hlotze/2_plus_7-Segmentanzeige/images/IMG_0500.JPG

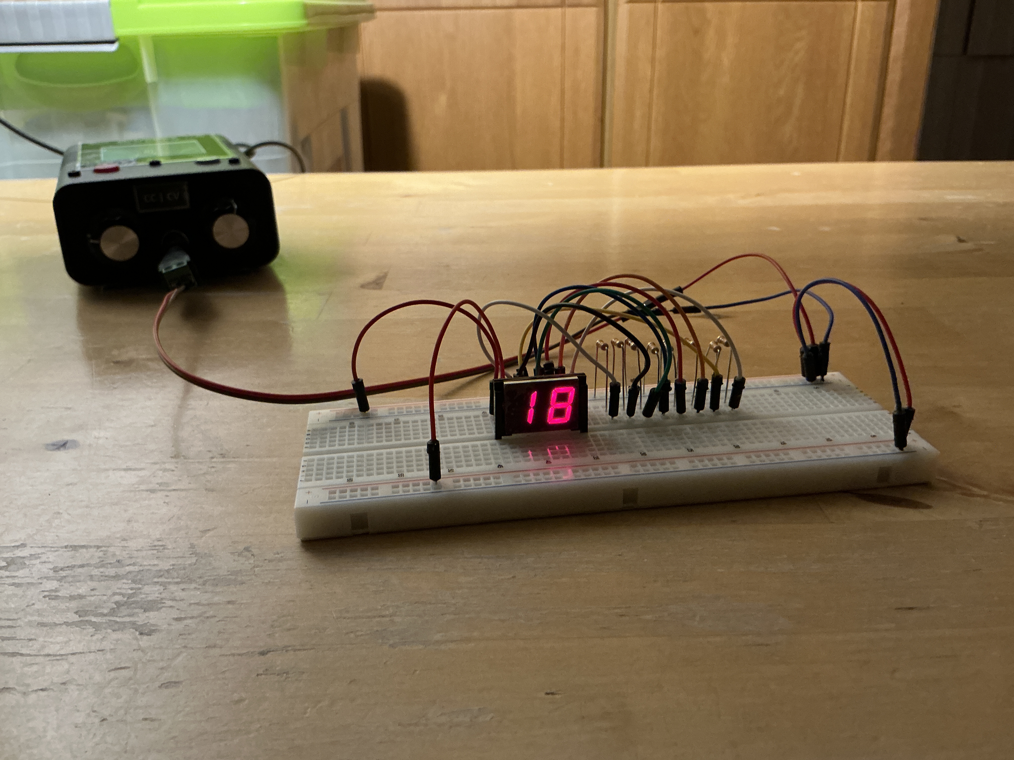
images/IMG_0500.JPG
