hlotze/2_plus_7-Segmentanzeige/images/Uno und Protoboard.png

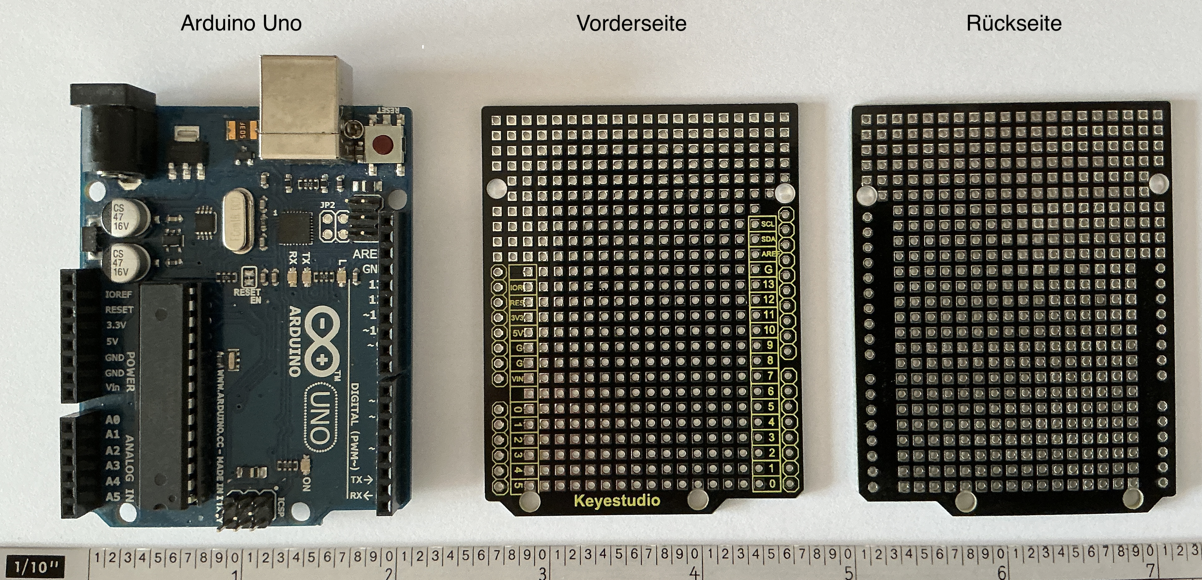
images/Uno und Protoboard.png
