hlotze/2_plus_7-Segmentanzeige/images/Anschluss_7-Segmentanzeige.jpg

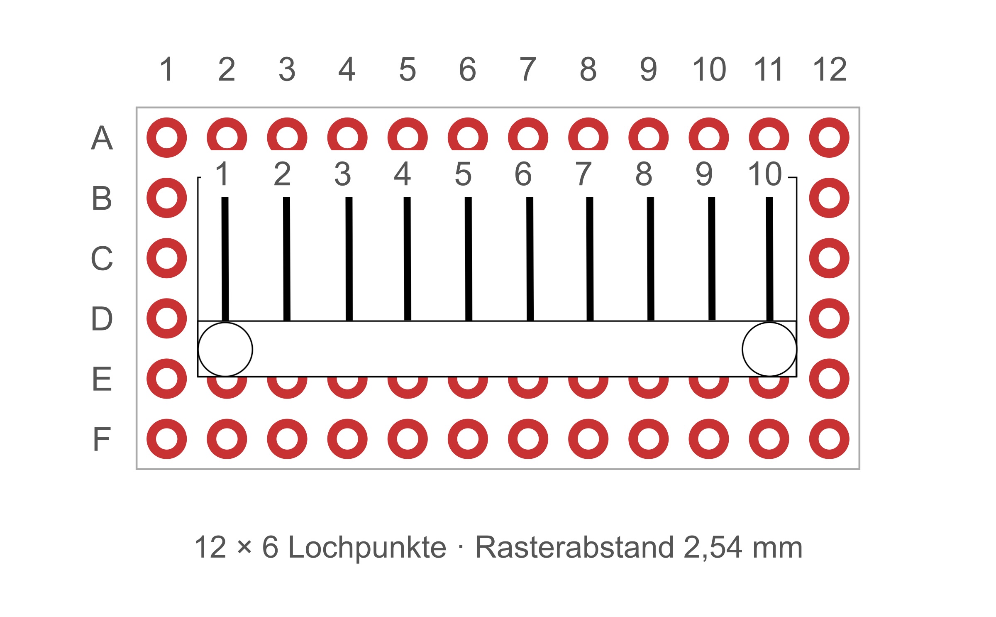
images/Anschluss_7-Segmentanzeige.jpg
