hlotze/2_plus_7-Segmentanzeige/images/ein_ein-Halb_7-Segmentanzeige_common_Anode.jpg

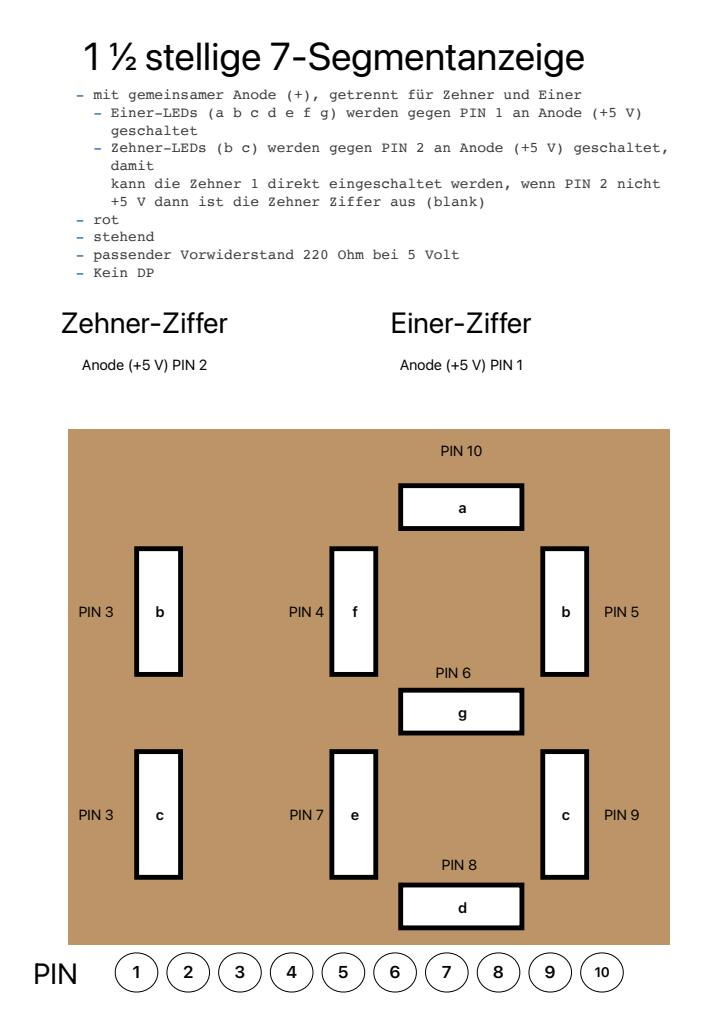
images/ein_ein-Halb_7-Segmentanzeige_common_Anode.jpg
