hlotze/2_plus_7-Segmentanzeige/uno_1_5_digit_display/kicad/render/schema.png

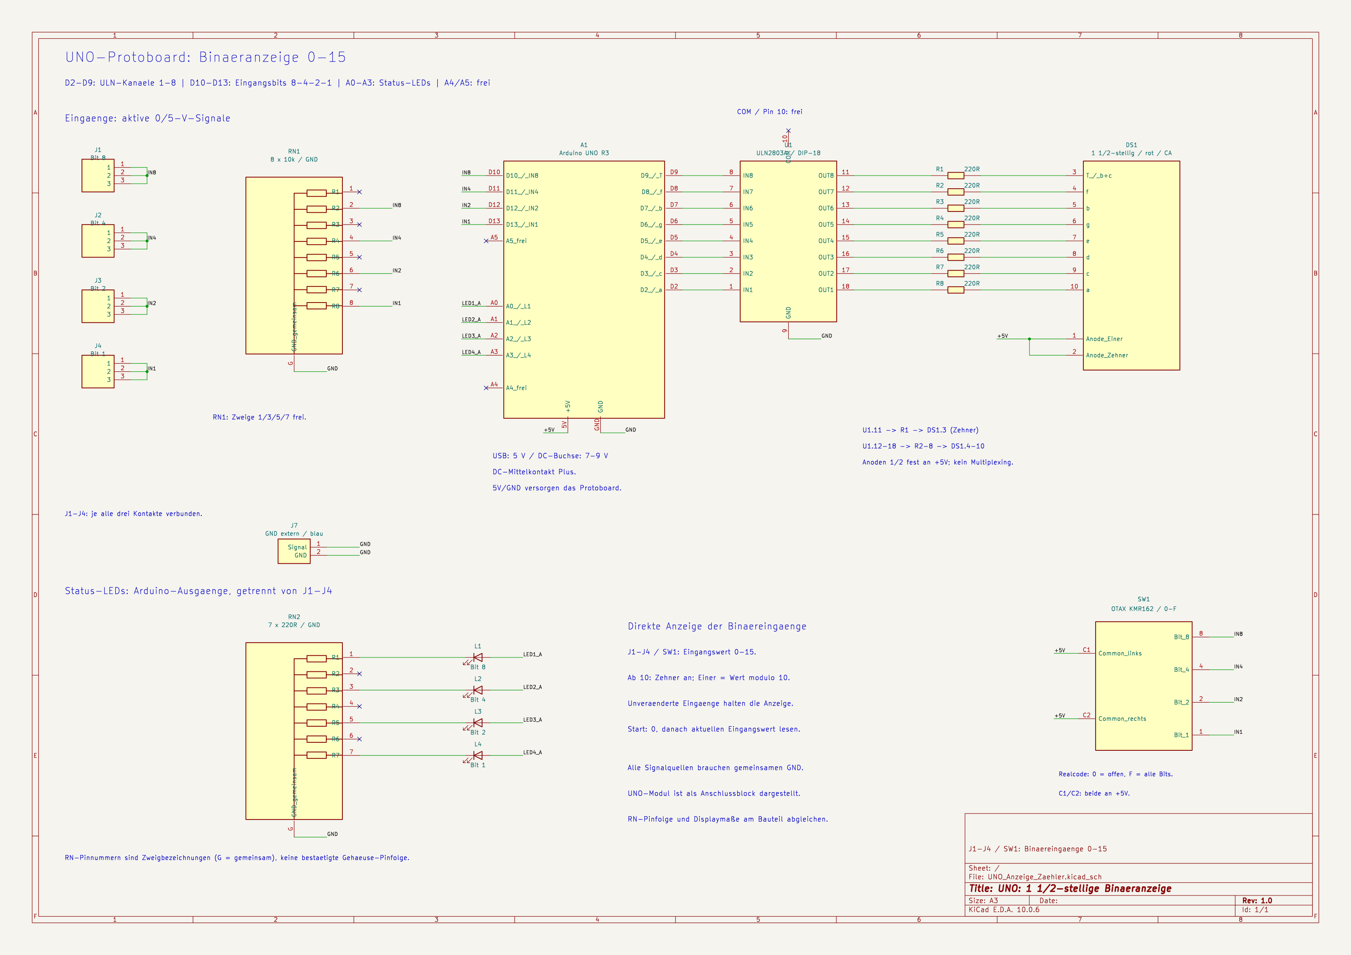
uno_1_5_digit_display/kicad/render/schema.png
