hlotze/2_plus_7-Segmentanzeige/uno_1_5_digit_display/protoboard_bestueckung copy.jpg

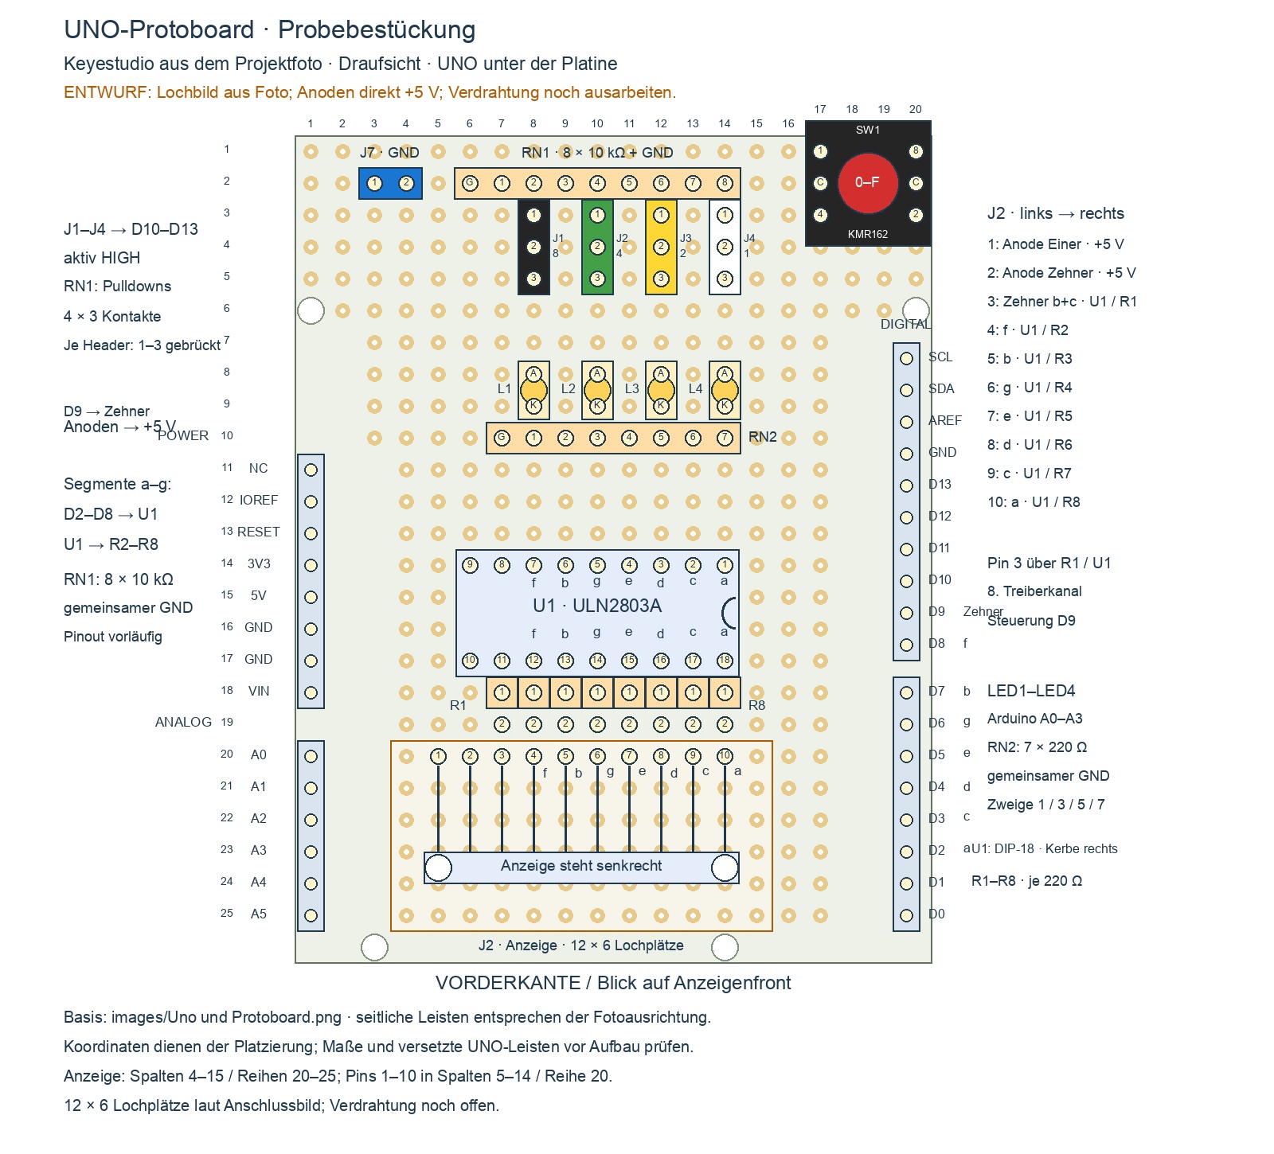
uno_1_5_digit_display/protoboard_bestueckung copy.jpg
