hlotze/2_plus_7-Segmentanzeige/uno_1_5_digit_display/verdrahtung_2_leds.png

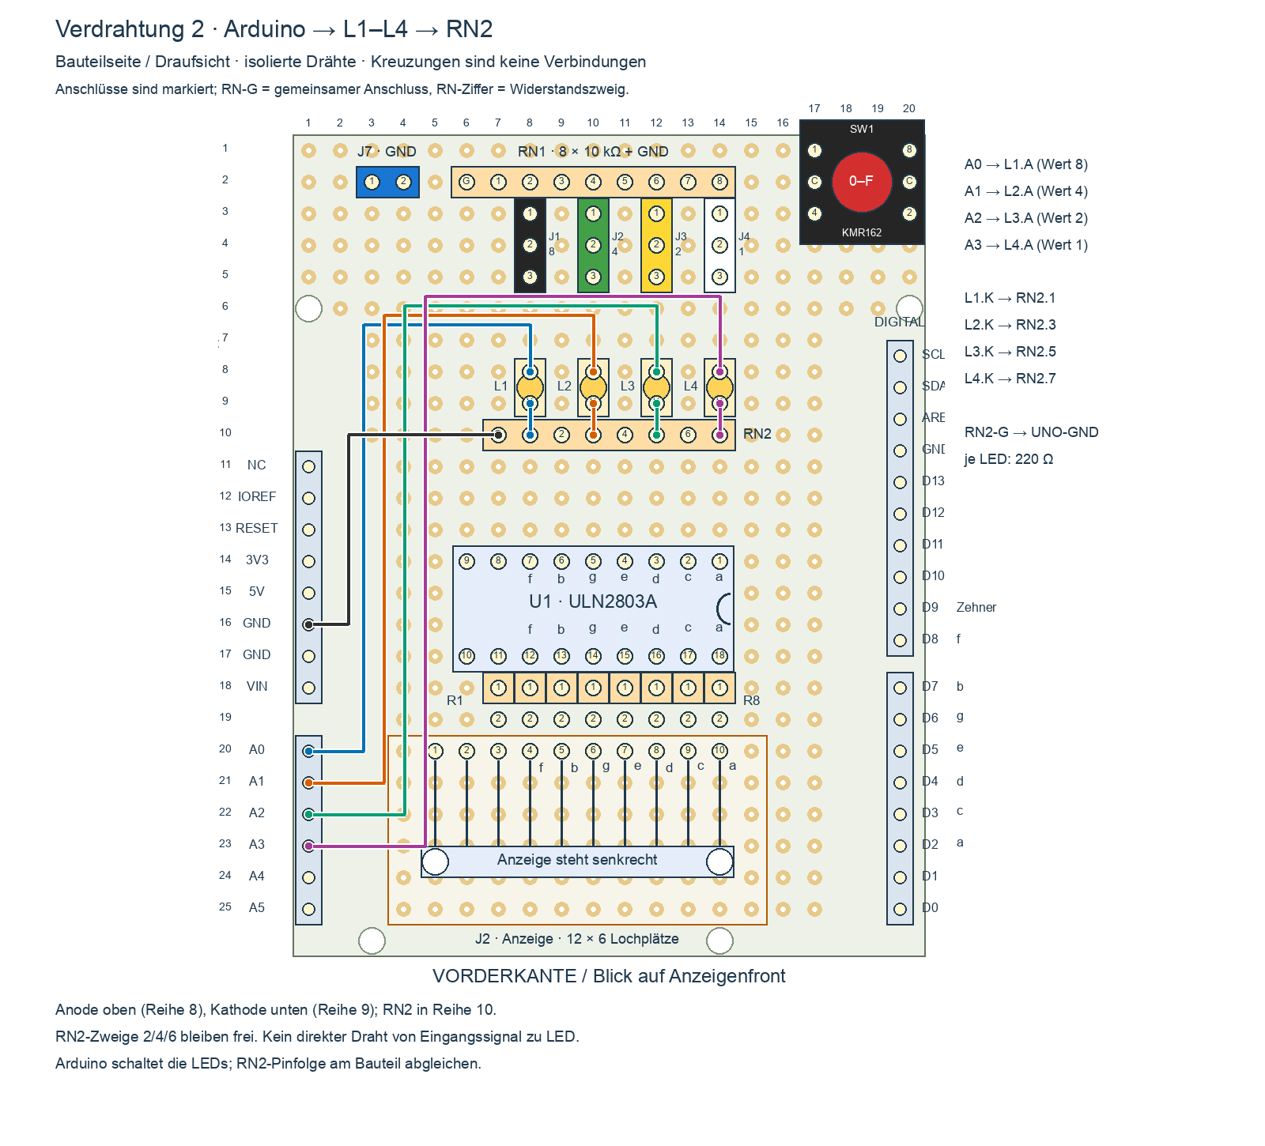
uno_1_5_digit_display/verdrahtung_2_leds.png
