hlotze/2_plus_7-Segmentanzeige/uno_1_5_digit_display/verdrahtung_3_uln.png

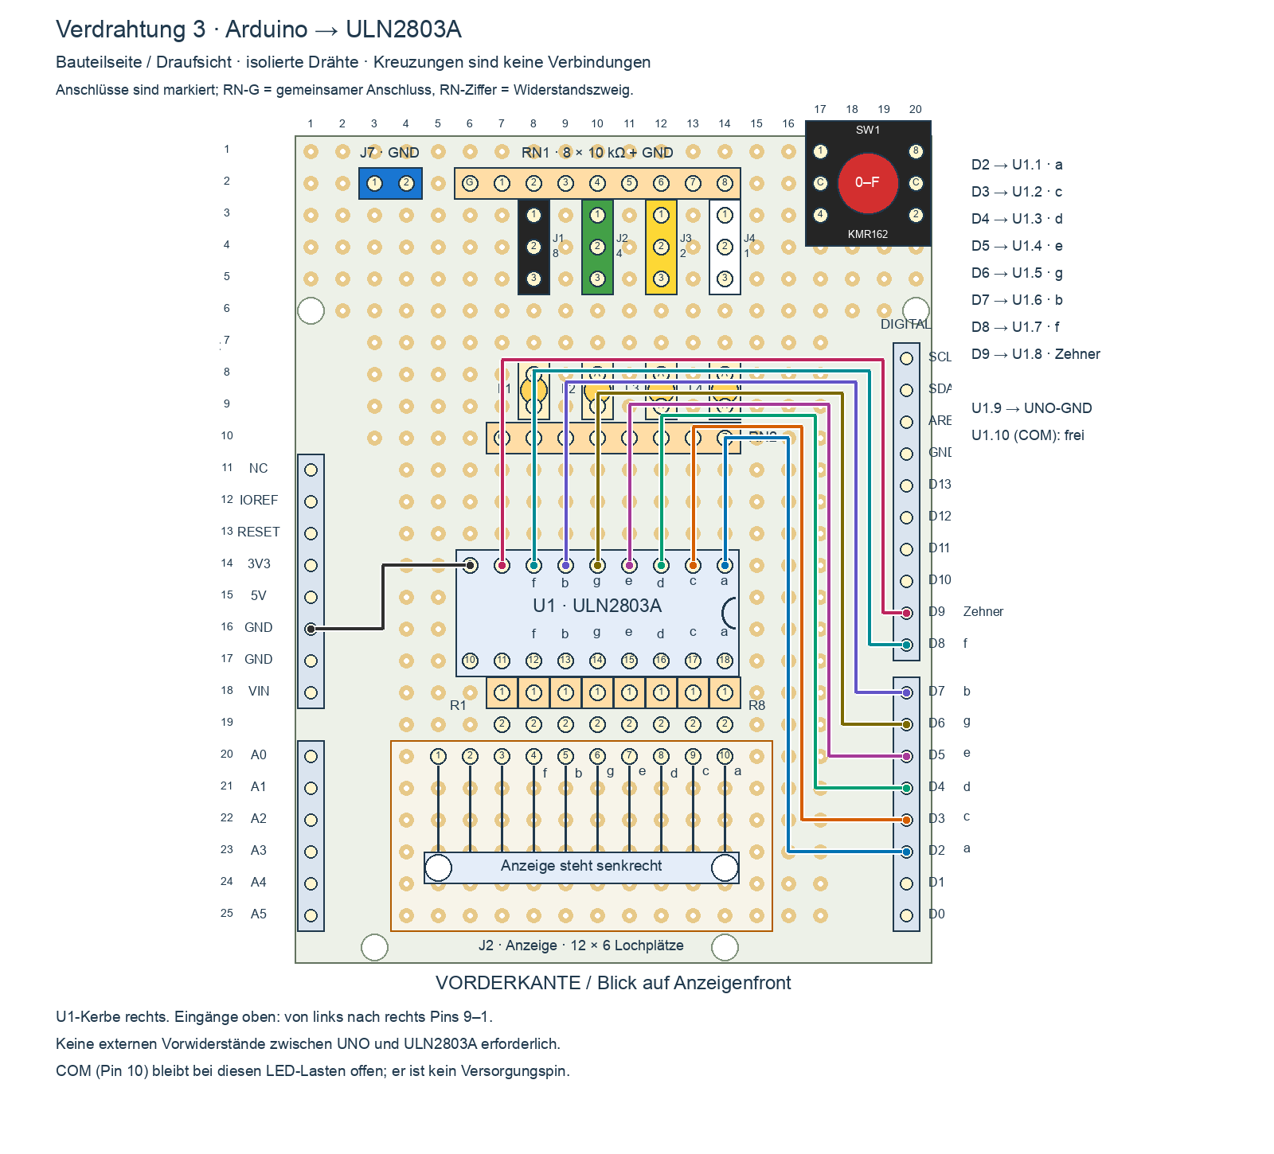
uno_1_5_digit_display/verdrahtung_3_uln.png
