hlotze/2_plus_7-Segmentanzeige/uno_1_5_digit_display/verdrahtung_4_anzeige.png

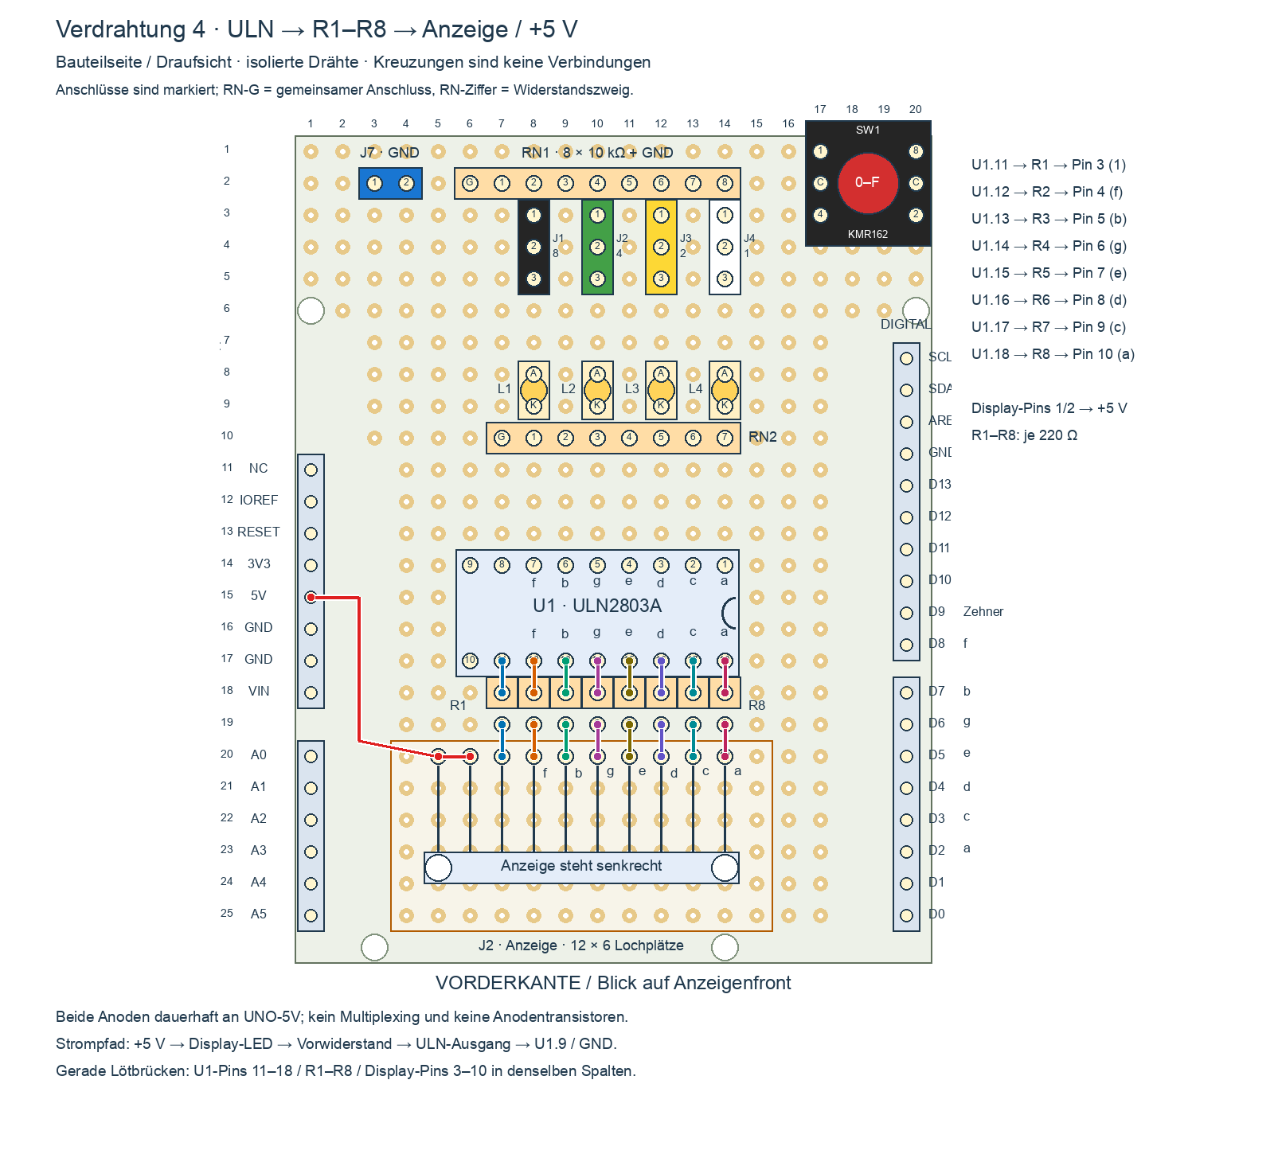
uno_1_5_digit_display/verdrahtung_4_anzeige.png
