hlotze/2_plus_7-Segmentanzeige/uno_1_5_digit_display/kicad/UNO_Anzeige_Zaehler.kicad_sch

## KiCad design uno_1_5_digit_display/kicad/UNO_Anzeige_Zaehler.kicad_sch (2026-10-13)

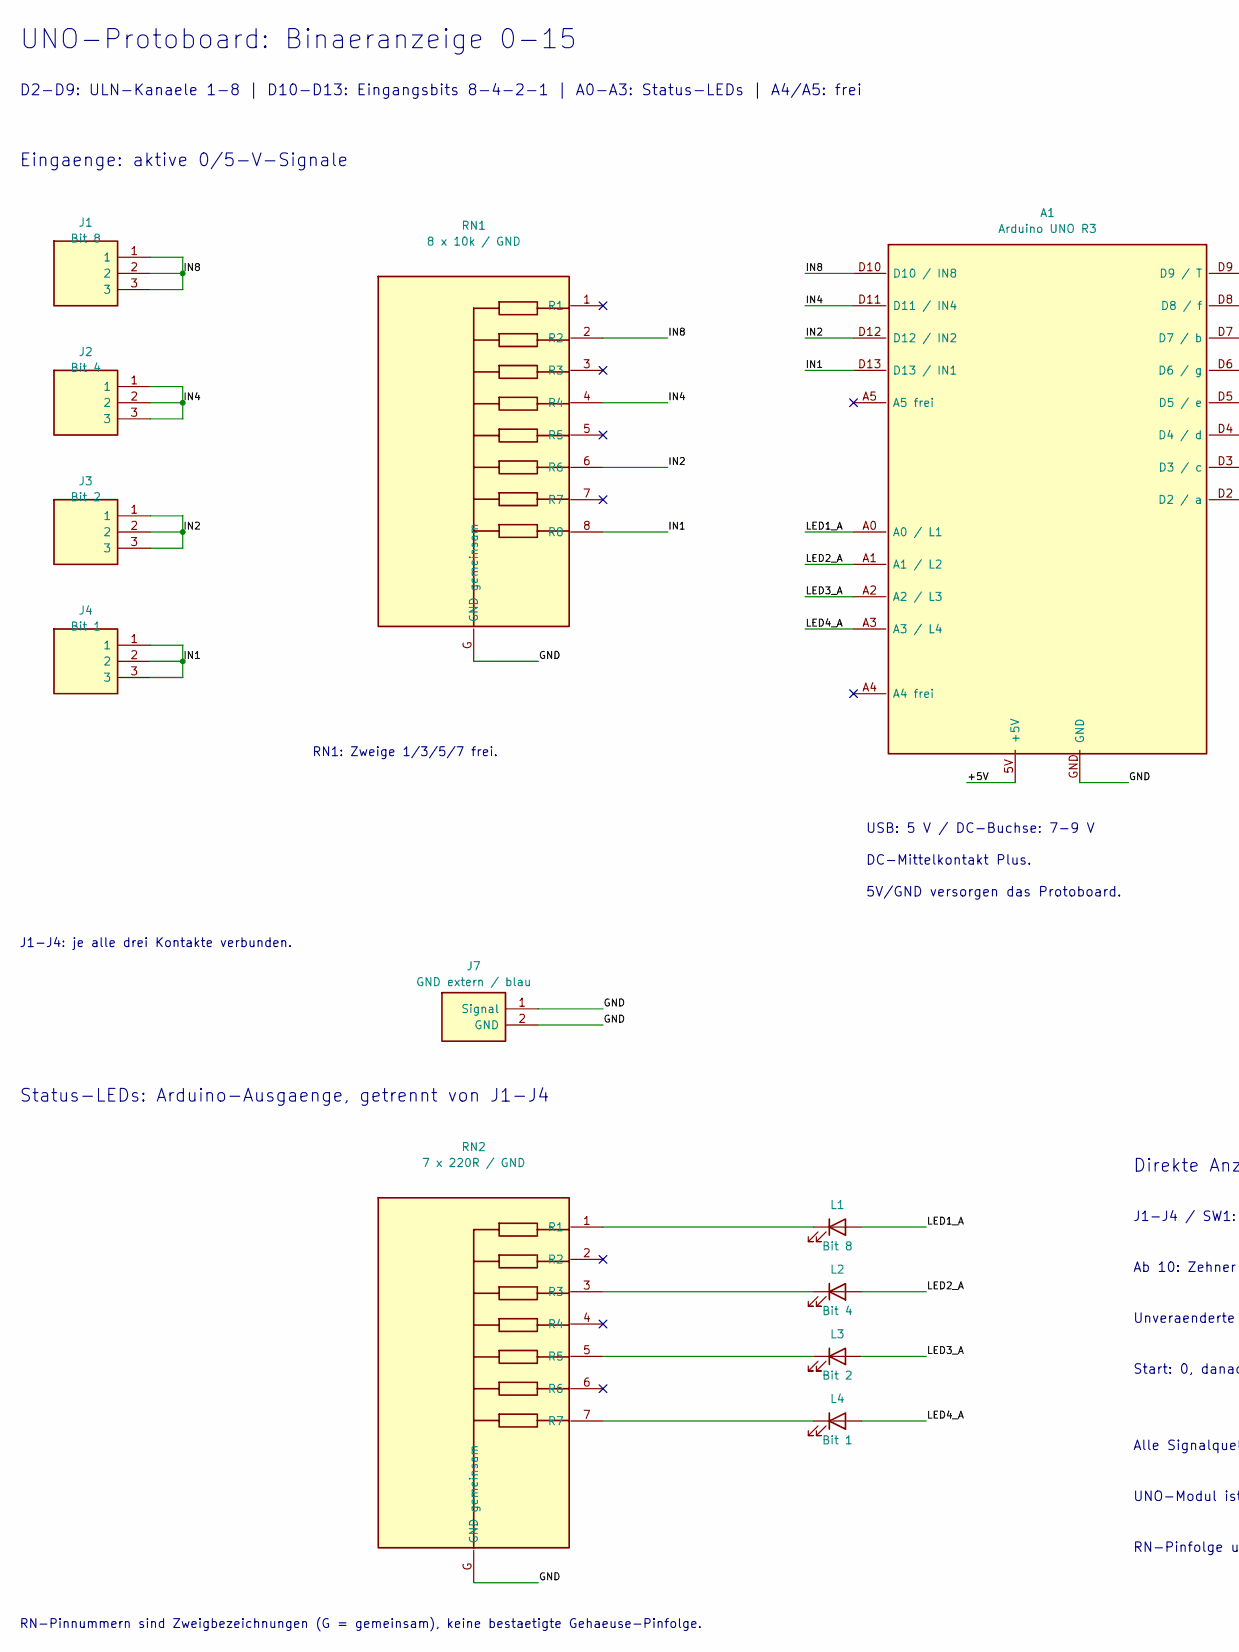
[picture p11: schematic UNO_Anzeige_Zaehler.kicad_sch, part in row 1, column 1]

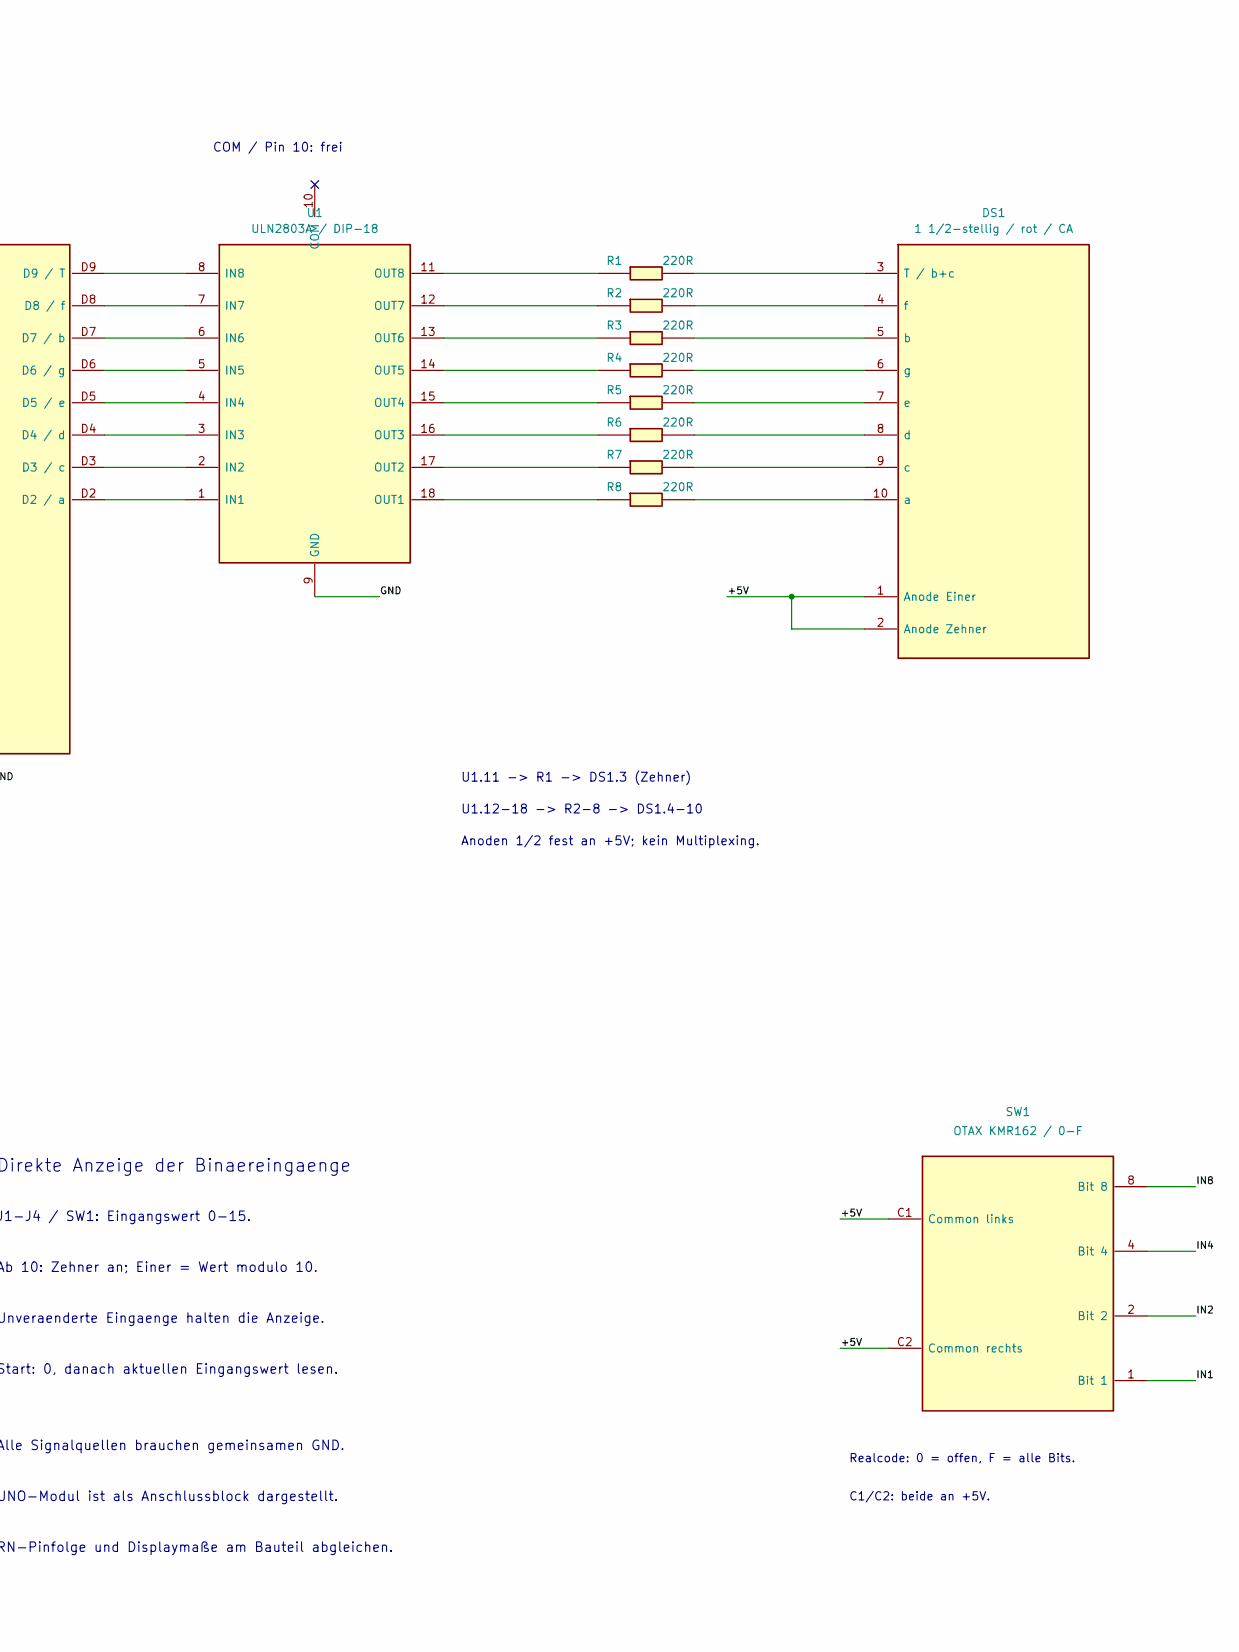
[picture p12: schematic UNO_Anzeige_Zaehler.kicad_sch, part in row 1, column 2]

Parts:
A1: Arduino UNO R3
DS1: 1 1/2-stellig / rot / CA
J1: Bit 8
J2: Bit 4
J3: Bit 2
J4: Bit 1
J7: GND extern / blau
L1: Bit 8
L2: Bit 4
L3: Bit 2
L4: Bit 1
R1, R2, R3, R4, R5, R6, R7, R8: 220R
RN1: 8 x 10k / GND
RN2: 7 x 220R / GND
SW1: OTAX KMR162 / 0-F
U1: ULN2803A / DIP-18

Connections:
+5V: A1.5V (+5V), DS1.1 (Anode Einer), DS1.2 (Anode Zehner), SW1.C1 (Common links), SW1.C2 (Common rechts)
GND: A1.GND, J7.1 (Signal), J7.2 (GND), RN1.G (GND gemeinsam), RN2.G (GND gemeinsam), U1.9 (GND)
IN1: A1.D13 (D13 / IN1), J4.1, J4.2, J4.3, RN1.8 (R8), SW1.1 (Bit 1)
IN2: A1.D12 (D12 / IN2), J3.1, J3.2, J3.3, RN1.6 (R6), SW1.2 (Bit 2)
IN4: A1.D11 (D11 / IN4), J2.1, J2.2, J2.3, RN1.4 (R4), SW1.4 (Bit 4)
IN8: A1.D10 (D10 / IN8), J1.1, J1.2, J1.3, RN1.2 (R2), SW1.8 (Bit 8)
LED1_A: A1.A0 (A0 / L1), L1.2 (A)
LED2_A: A1.A1 (A1 / L2), L2.2 (A)
LED3_A: A1.A2 (A2 / L3), L3.2 (A)
LED4_A: A1.A3 (A3 / L4), L4.2 (A)
unnamed: A1.D2 (D2 / a), U1.1 (IN1)
unnamed: A1.D3 (D3 / c), U1.2 (IN2)
unnamed: A1.D4 (D4 / d), U1.3 (IN3)
unnamed: A1.D5 (D5 / e), U1.4 (IN4)
unnamed: A1.D6 (D6 / g), U1.5 (IN5)
unnamed: A1.D7 (D7 / b), U1.6 (IN6)
unnamed: A1.D8 (D8 / f), U1.7 (IN7)
unnamed: A1.D9 (D9 / T), U1.8 (IN8)
unnamed: DS1.3 (T / b+c), R1.2
unnamed: DS1.4 (f), R2.2
unnamed: DS1.5 (b), R3.2
unnamed: DS1.6 (g), R4.2
unnamed: DS1.7 (e), R5.2
unnamed: DS1.8 (d), R6.2
unnamed: DS1.9 (c), R7.2
unnamed: DS1.10 (a), R8.2
unnamed: L1.1 (K), RN2.1 (R1)
unnamed: L2.1 (K), RN2.3 (R3)
unnamed: L3.1 (K), RN2.5 (R5)
unnamed: L4.1 (K), RN2.7 (R7)
unnamed: R1.1, U1.11 (OUT8)
unnamed: R2.1, U1.12 (OUT7)
unnamed: R3.1, U1.13 (OUT6)
unnamed: R4.1, U1.14 (OUT5)
unnamed: R5.1, U1.15 (OUT4)
unnamed: R6.1, U1.16 (OUT3)
unnamed: R7.1, U1.17 (OUT2)
unnamed: R8.1, U1.18 (OUT1)

Notes on the sheet:
UNO-Protoboard: Binaeranzeige 0-15
D2-D9: ULN-Kanaele 1-8 | D10-D13: Eingangsbits 8-4-2-1 | A0-A3: Status-LEDs | A4/A5: frei
Eingaenge: aktive 0/5-V-Signale
RN1: Zweige 1/3/5/7 frei.
J1-J4: je alle drei Kontakte verbunden.
USB: 5 V / DC-Buchse: 7-9 V
DC-Mittelkontakt Plus.
5V/GND versorgen das Protoboard.
COM / Pin 10: frei
U1.11 -> R1 -> DS1.3 (Zehner)
U1.12-18 -> R2-8 -> DS1.4-10
Anoden 1/2 fest an +5V; kein Multiplexing.
Status-LEDs: Arduino-Ausgaenge, getrennt von J1-J4
RN-Pinnummern sind Zweigbezeichnungen (G = gemeinsam), keine bestaetigte Gehaeuse-Pinfolge.
Realcode: 0 = offen, F = alle Bits.
C1/C2: beide an +5V.
Direkte Anzeige der Binaereingaenge
J1-J4 / SW1: Eingangswert 0-15.
Ab 10: Zehner an; Einer = Wert modulo 10.
Unveraenderte Eingaenge halten die Anzeige.
Start: 0, danach aktuellen Eingangswert lesen.
Alle Signalquellen brauchen gemeinsamen GND.
UNO-Modul ist als Anschlussblock dargestellt.
RN-Pinfolge und Displaymaße am Bauteil abgleichen.
